dchwebb/DevBoard/Base_Controls.step

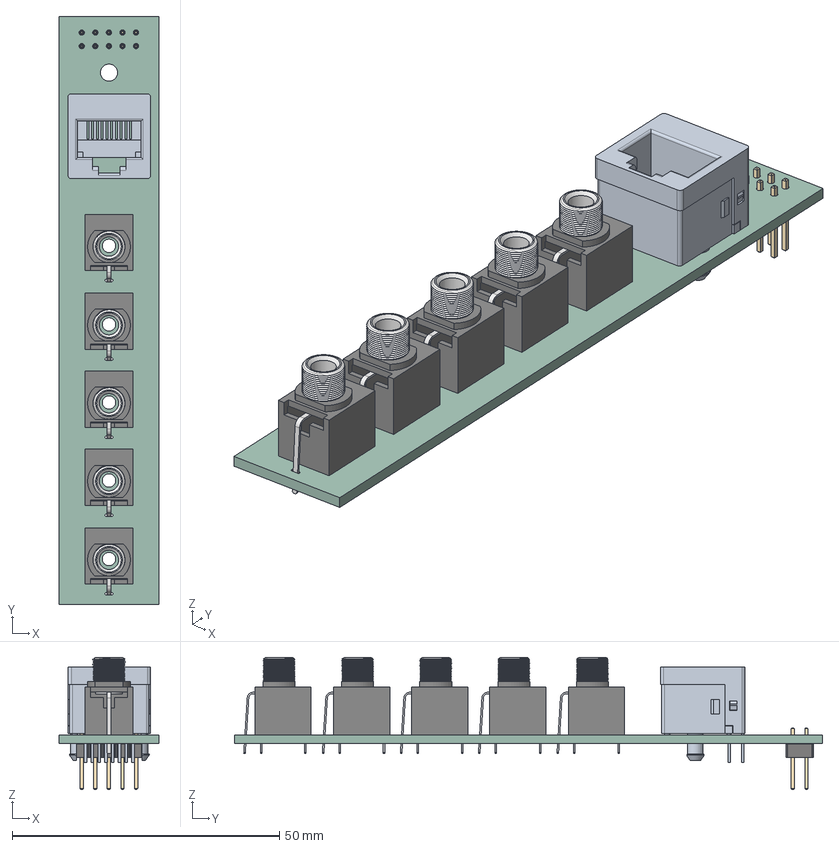
[picture p1: CAD file, 2023-03-30]
Base_Controls.step
18.8 x 110.0 x 24.7 mm
PCB
