dchwebb/DevBoard/Base_Controls.kicad_pcb

## KiCad design Base_Controls.kicad_pcb (2023-08-18)

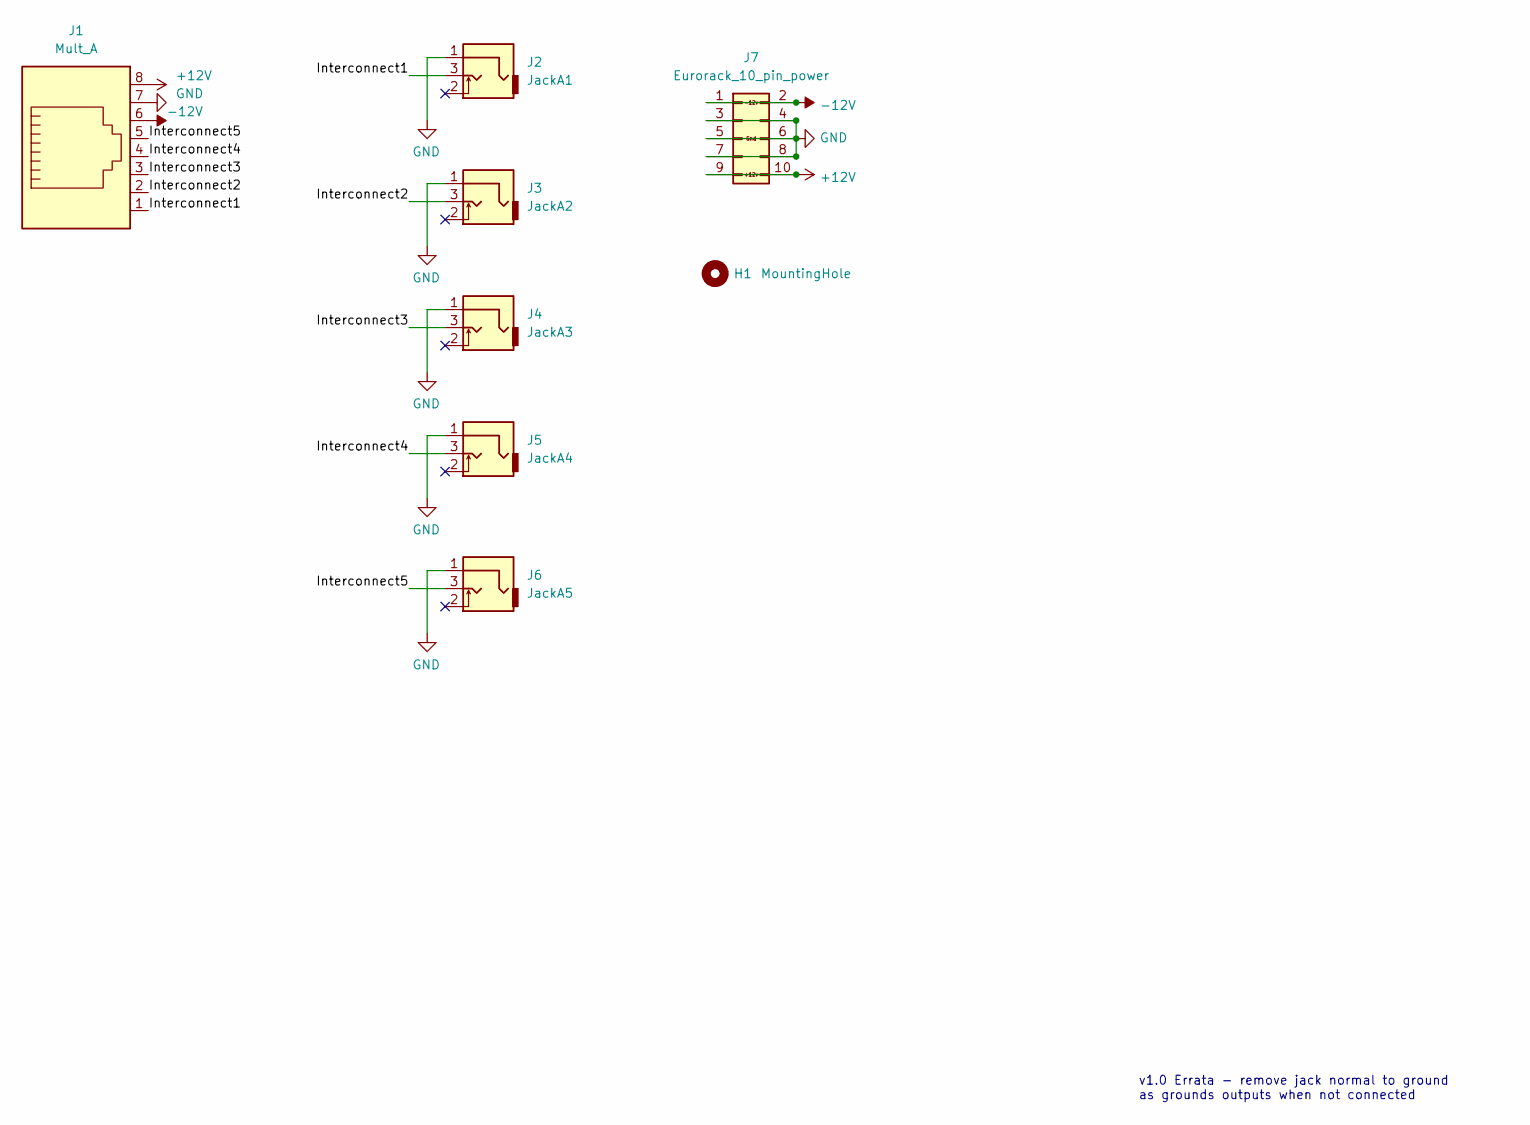
[picture p2: schematic Base_Controls.kicad_sch, Quadraphone Controls]

Parts:
H1: MountingHole; MountingHole_3.2mm_M3_ISO14580
J1: Mult_A; RJ45_Molex_42878-8506
J2: JackA1; THONKICONN_hole
J3: JackA2; THONKICONN_hole
J4: JackA3; THONKICONN_hole
J5: JackA4; THONKICONN_hole
J6: JackA5; THONKICONN_hole
J7: Eurorack_10_pin_power; PinHeader_2x05_P2.54mm_Vertical

Connections:
+12V: J1.8, J7.9, J7.10
-12V: J1.6, J7.1, J7.2
/Interconnect1: J1.1, J2.3
/Interconnect2: J1.2, J3.3
/Interconnect3: J1.3, J4.3
/Interconnect4: J1.4, J5.3
/Interconnect5: J1.5, J6.3
GND: J1.7, J2.1, J3.1, J4.1, J5.1, J6.1, J7.3, J7.4, J7.5, J7.6, J7.7, J7.8

Notes on the sheet:
v1.0 Errata - remove jack normal to ground as grounds outputs when not connected

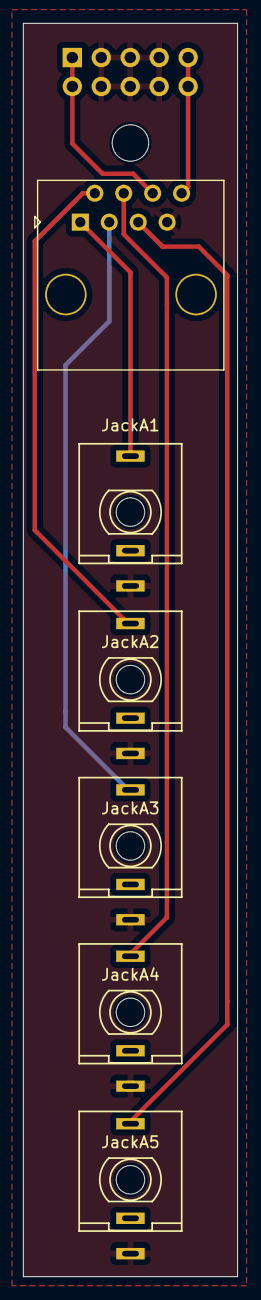
[picture p3: board Base_Controls.kicad_pcb from above]

Board: 2 copper layers, 18.8 x 110.0 mm, 8 parts (1 on the bottom side), 8 nets.
