dchwebb/DevBoard/DevBoard.kicad_pcb

## KiCad design DevBoard.kicad_pcb (2023-03-30)

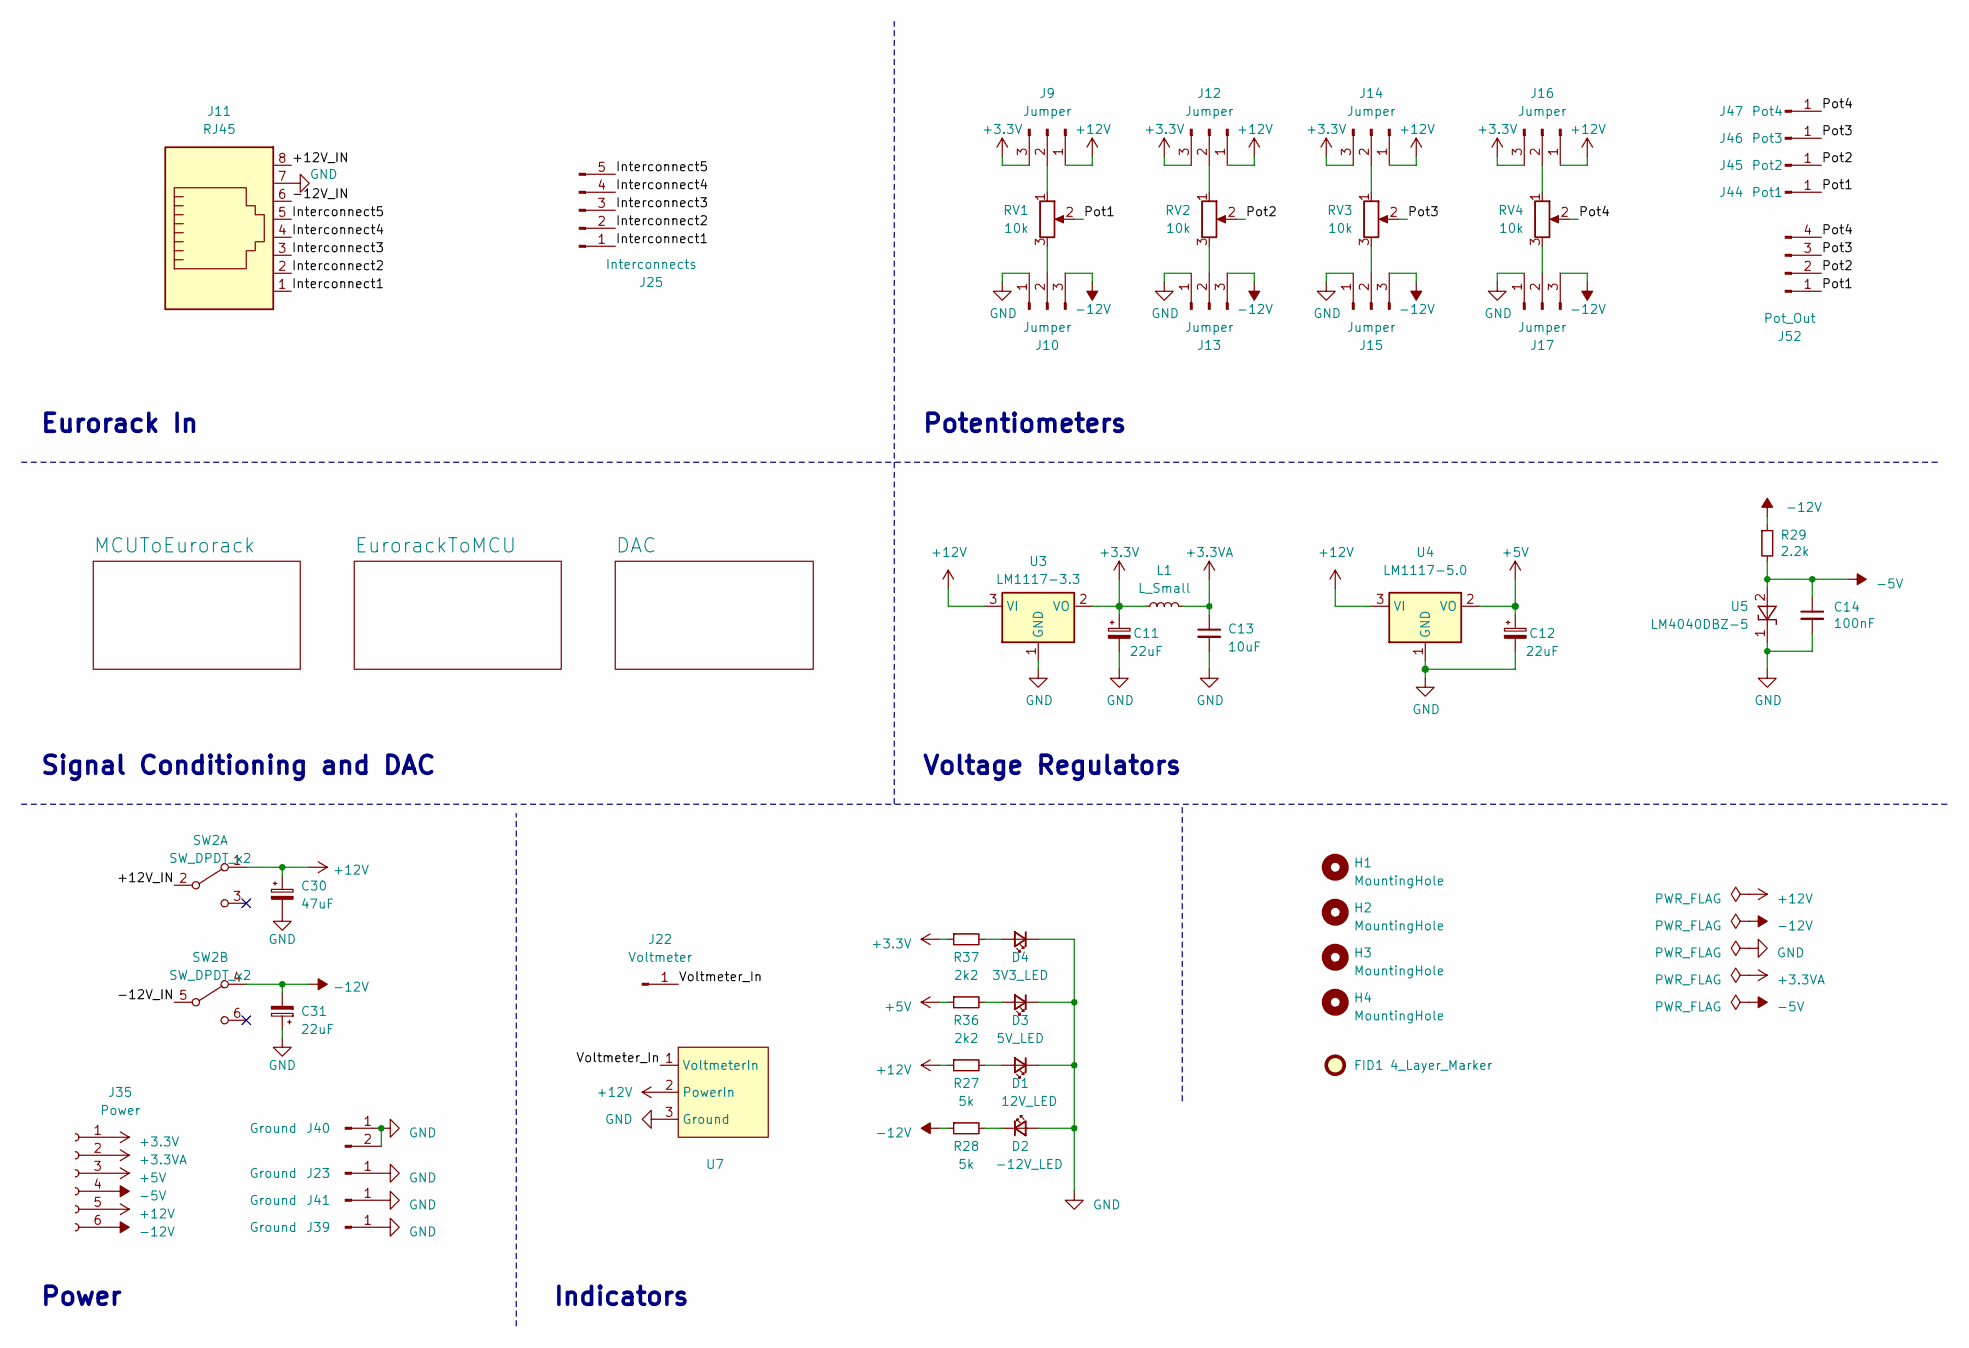
[picture p4: schematic DevBoard.kicad_sch, Eurorack Dev Board]

Parts:
C11, C12, C31: 22uF; CP_Elec_4x5.8
C13: 10uF; C_0805_2012Metric
C14: 100nF; C_0805_2012Metric
C30: 47uF; CP_Elec_5x5.4
D1: 12V_LED; LED_0603_1608Metric
D2: -12V_LED; LED_0603_1608Metric
D3: 5V_LED; LED_0603_1608Metric
D4: 3V3_LED; LED_0603_1608Metric
FID1: 4_Layer_Marker; 4_Layer_Markers
H1, H2, H3, H4: MountingHole; MountingHole_3.2mm_M3
J9, J10, J12, J13, J14, J15, J16, J17: Jumper; PinHeader_1x03_P2.54mm_Vertical
J11: RJ45; RJ45_Amphenol_Style
J22: Voltmeter; PinSocket_1x01_P2.54mm_Vertical
J23, J39, J41: Ground; PinHeader_1x01_P2.54mm_Vertical
J25: Interconnects; PinSocket_1x05_P2.54mm_Vertical
J35: Power; PinSocket_1x06_P2.54mm_Vertical
J40: Ground; PinSocket_1x02_P2.54mm_Vertical
J44: Pot1; PinHeader_1x01_P2.54mm_Vertical
J45: Pot2; PinHeader_1x01_P2.54mm_Vertical
J46: Pot3; PinHeader_1x01_P2.54mm_Vertical
J47: Pot4; PinHeader_1x01_P2.54mm_Vertical
J52: Pot_Out; PinSocket_1x04_P2.54mm_Vertical
L1: L_Small; L_0805_2012Metric_Pad1.05x1.20mm_HandSolder; Part_Number C1046
R27, R28: 5k; R_0805_2012Metric
R29: 2.2k; R_0805_2012Metric
R36, R37: 2k2; R_0805_2012Metric
RV1, RV2, RV3, RV4: 10k; Alpha_9mm_Potentiometer_Aligned
SW2: SW_DPDT_x2; 100DP6T1B1M2QE_ON_ON_ON
U3: LM1117-3.3; SOT-223-3_TabPin2
U4: LM1117-5.0; SOT-223-3_TabPin2
U5: LM4040DBZ-5; SOT-23
U7: MiniVoltmeter

Connections:
+3.3V: C11.1, J9.3, J12.3, J14.3, J16.3, J35.1, L1.1, R37.1, U3.2 (VO); also elsewhere on the board
+3.3VA: C13.1, J35.2, L1.2; also elsewhere on the board
+5V: C12.1, J35.3, R36.1, U4.2 (VO)
+12V: C30.1, J9.1, J12.1, J14.1, J16.1, J35.5, R27.1, SW2.1 (A), U3.3 (VI), U4.3 (VI), U7.2 (PowerIn); also elsewhere on the board
-5V: C14.1, J35.4, R29.2, U5.2 (A); also elsewhere on the board
-12V: C31.2, J10.3, J13.3, J15.3, J17.3, J35.6, R28.1, R29.1, SW2.4 (A); also elsewhere on the board
/+12V_IN: J11.8, SW2.2 (B)
/-12V_IN: J11.6, SW2.5 (B)
/Interconnect1: J11.1, J25.1
/Interconnect2: J11.2, J25.2
/Interconnect3: J11.3, J25.3
/Interconnect4: J11.4, J25.4
/Interconnect5: J11.5, J25.5
/Pot1: J44.1, J52.1, RV1.2
/Pot2: J45.1, J52.2, RV2.2
/Pot3: J46.1, J52.3, RV3.2
/Pot4: J47.1, J52.4, RV4.2
/Voltmeter_In: J22.1, U7.1 (VoltmeterIn)
GND: C11.2, C12.2, C13.2, C14.2, C30.2, C31.1, D1.1 (K), D2.2 (A), D3.1 (K), D4.1 (K), J10.1, J11.7, J13.1, J15.1, J17.1, J23.1, J39.1, J40.1, J40.2, J41.1, U3.1 (GND), U4.1 (GND), U5.1 (K), U7.3 (Ground); also elsewhere on the board
unnamed: D1.2 (A), R27.2
unnamed: D2.1 (K), R28.2
unnamed: D3.2 (A), R36.2
unnamed: D4.2 (A), R37.2
unnamed: J9.2, RV1.1
unnamed: J10.2, RV1.3
unnamed: J12.2, RV2.1
unnamed: J13.2, RV2.3
unnamed: J14.2, RV3.1
unnamed: J15.2, RV3.3
unnamed: J16.2, RV4.1
unnamed: J17.2, RV4.3

Notes on the sheet:
Eurorack In
Potentiometers
Indicators
Power
Voltage Regulators
Signal Conditioning and DAC

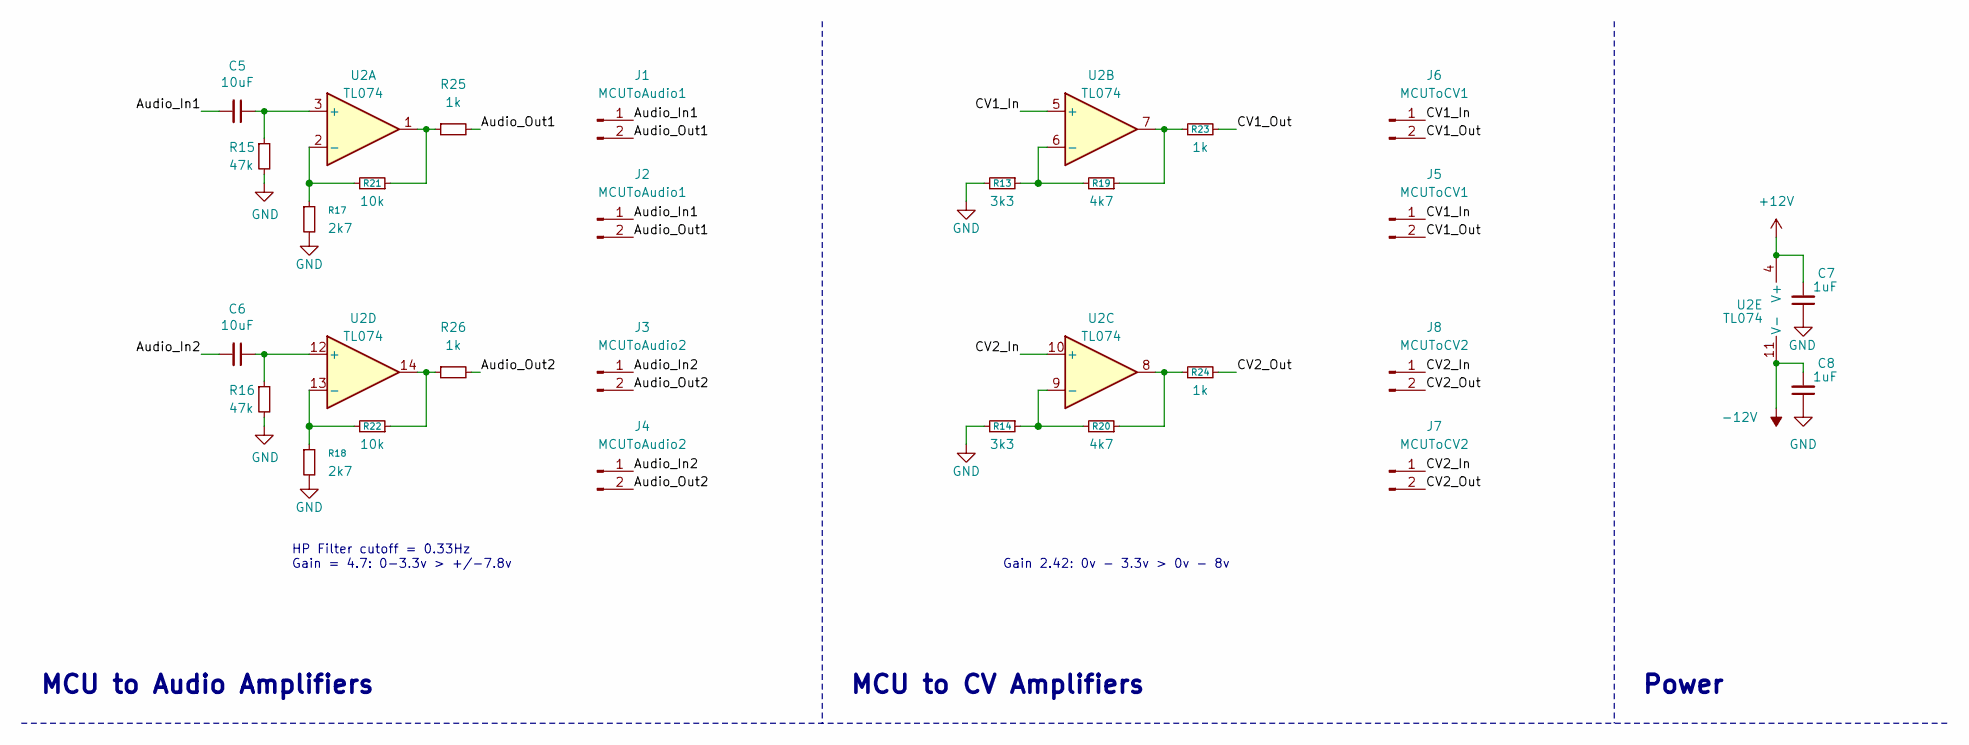
[picture p5: schematic MCUToEurorack.kicad_sch, Eurorack Dev Board]

Parts:
C5, C6: 10uF; C_0805_2012Metric
C7, C8: 1uF; C_0805_2012Metric
J1: MCUToAudio1; PinSocket_1x02_P2.54mm_Vertical
J2: MCUToAudio1; PinHeader_1x02_P2.54mm_Vertical
J3: MCUToAudio2; PinSocket_1x02_P2.54mm_Vertical
J4: MCUToAudio2; PinHeader_1x02_P2.54mm_Vertical
J5: MCUToCV1; PinHeader_1x02_P2.54mm_Vertical
J6: MCUToCV1; PinSocket_1x02_P2.54mm_Vertical
J7: MCUToCV2; PinHeader_1x02_P2.54mm_Vertical
J8: MCUToCV2; PinSocket_1x02_P2.54mm_Vertical
R13, R14: 3k3; R_0805_2012Metric; Part_Number C22978
R15, R16: 47k; R_0805_2012Metric
R17, R18: 2k7; R_0805_2012Metric; Part_Number C22978
R19, R20: 4k7; R_0805_2012Metric; Part_Number C23162
R21, R22: 10k; R_0805_2012Metric; Part_Number C23162
R23, R24: 1k; R_0805_2012Metric; Part_Number C21190
R25, R26: 1k; R_0805_2012Metric
U2: TL074; SOIC-14_3.9x8.7mm_P1.27mm

Connections:
+12V: C7.2, U2.4 (V+); also elsewhere on the board
-12V: C8.2, U2.11 (V-); also elsewhere on the board
/MCUToEurorack/Audio_In1: C5.2, J1.1, J2.1
/MCUToEurorack/Audio_In2: C6.2, J3.1, J4.1
/MCUToEurorack/Audio_Out1: J1.2, J2.2, R25.2
/MCUToEurorack/Audio_Out2: J3.2, J4.2, R26.2
/MCUToEurorack/CV1_In: J5.1, J6.1, U2.5 (+)
/MCUToEurorack/CV1_Out: J5.2, J6.2, R23.2
/MCUToEurorack/CV2_In: J7.1, J8.1, U2.10 (+)
/MCUToEurorack/CV2_Out: J7.2, J8.2, R24.2
GND: C7.1, C8.1, R13.2, R14.2, R15.2, R16.2, R17.2, R18.2; also elsewhere on the board
unnamed: R19.1, R23.1, U2.7
unnamed: R20.1, R24.1, U2.8
unnamed: R21.1, R25.1, U2.1
unnamed: R22.1, R26.1, U2.14
unnamed: C5.1, R15.1, U2.3 (+)
unnamed: R17.1, R21.2, U2.2 (-)
unnamed: R13.1, R19.2, U2.6 (-)
unnamed: R14.1, R20.2, U2.9 (-)
unnamed: C6.1, R16.1, U2.12 (+)
unnamed: R18.1, R22.2, U2.13 (-)

Notes on the sheet:
HP Filter cutoff = 0.33Hz Gain = 4.7: 0-3.3v > +/-7.8v
MCU to Audio Amplifiers
MCU to CV Amplifiers
Gain 2.42: 0v - 3.3v > 0v - 8v
Power

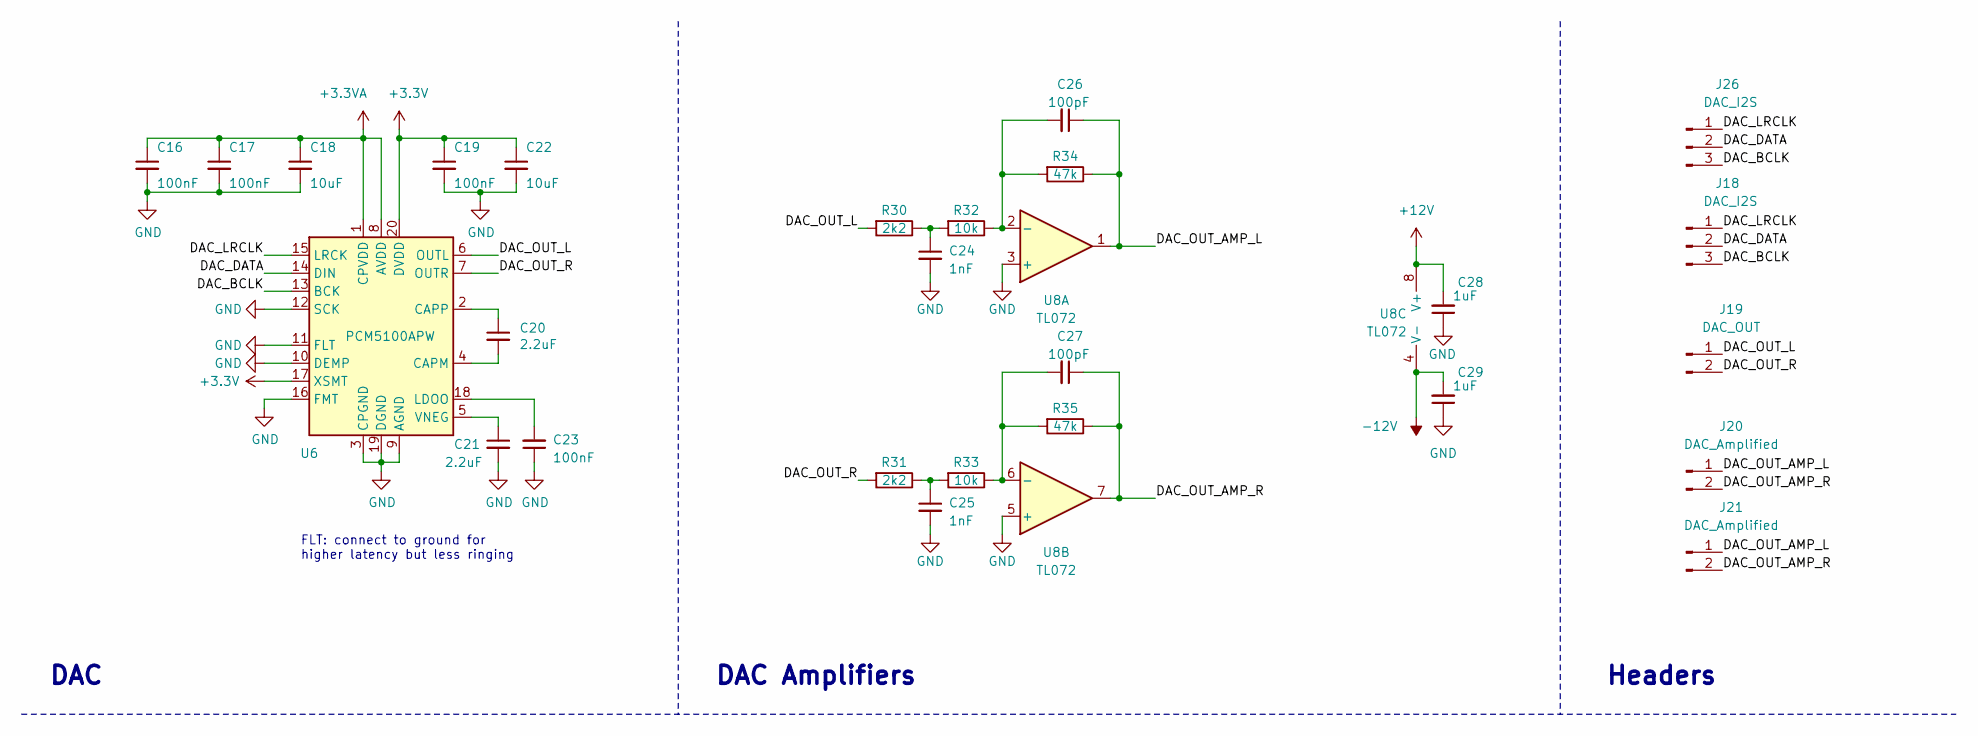
[picture p6: schematic DAC.kicad_sch, Eurorack Dev Board]

Parts:
C16, C17, C19, C23: 100nF; C_0805_2012Metric; Part_Number C14663
C18, C22: 10uF; C_0805_2012Metric; Part_Number C15850
C20, C21: 2.2uF; C_0805_2012Metric; Part_Number C23630
C24, C25: 1nF; C_0805_2012Metric; Part_Number C1588
C26, C27: 100pF; C_0805_2012Metric; Part_Number C14858
C28, C29: 1uF; C_0805_2012Metric
J18: DAC_I2S; PinHeader_1x03_P2.54mm_Vertical
J19: DAC_OUT; PinHeader_1x02_P2.54mm_Vertical
J20: DAC_Amplified; PinSocket_1x02_P2.54mm_Vertical
J21: DAC_Amplified; PinHeader_1x02_P2.54mm_Vertical
J26: DAC_I2S; PinSocket_1x03_P2.54mm_Vertical
R30, R31: 2k2; R_0805_2012Metric; Part_Number C4190
R32, R33: 10k; R_0805_2012Metric; Part_Number C25804
R34, R35: 47k; R_0805_2012Metric; Part_Number C25819
U6: PCM5100APW; TSSOP-20_4.4x6.5mm_P0.65mm; Part_Number C131154
U8: TL072; SOIC-8_3.9x4.9mm_P1.27mm; Part_Number C6961

Connections:
+3.3V: C19.1, C22.1, U6.17 (XSMT), U6.20 (DVDD); also elsewhere on the board
+3.3VA: C16.1, C17.1, C18.1, U6.1 (CPVDD), U6.8 (AVDD); also elsewhere on the board
+12V: C28.2, U8.8 (V+); also elsewhere on the board
-12V: C29.2, U8.4 (V-); also elsewhere on the board
/DAC/DAC_BCLK: J18.3, J26.3, U6.13 (BCK)
/DAC/DAC_DATA: J18.2, J26.2, U6.14 (DIN)
/DAC/DAC_LRCLK: J18.1, J26.1, U6.15 (LRCK)
/DAC/DAC_OUT_AMP_L: C26.1, J20.1, J21.1, R34.1, U8.1
/DAC/DAC_OUT_AMP_R: C27.1, J20.2, J21.2, R35.1, U8.7
/DAC/DAC_OUT_L: J19.1, R30.2, U6.6 (OUTL)
/DAC/DAC_OUT_R: J19.2, R31.2, U6.7 (OUTR)
GND: C16.2, C17.2, C18.2, C19.2, C21.2, C22.2, C23.1, C24.2, C25.2, C28.1, C29.1, U6.3 (CPGND), U6.9 (AGND), U6.10 (DEMP), U6.11 (FLT), U6.12 (SCK), U6.16 (FMT), U6.19 (DGND), U8.3 (+), U8.5 (+); also elsewhere on the board
unnamed: C24.1, R30.1, R32.2
unnamed: C25.1, R31.1, R33.2
unnamed: C20.2, U6.4 (CAPM)
unnamed: C20.1, U6.2 (CAPP)
unnamed: C23.2, U6.18 (LDOO)
unnamed: C21.1, U6.5 (VNEG)
unnamed: C26.2, R32.1, R34.2, U8.2 (-)
unnamed: C27.2, R33.1, R35.2, U8.6 (-)

Notes on the sheet:
Headers
DAC Amplifiers
DAC
FLT: connect to ground for higher latency but less ringing

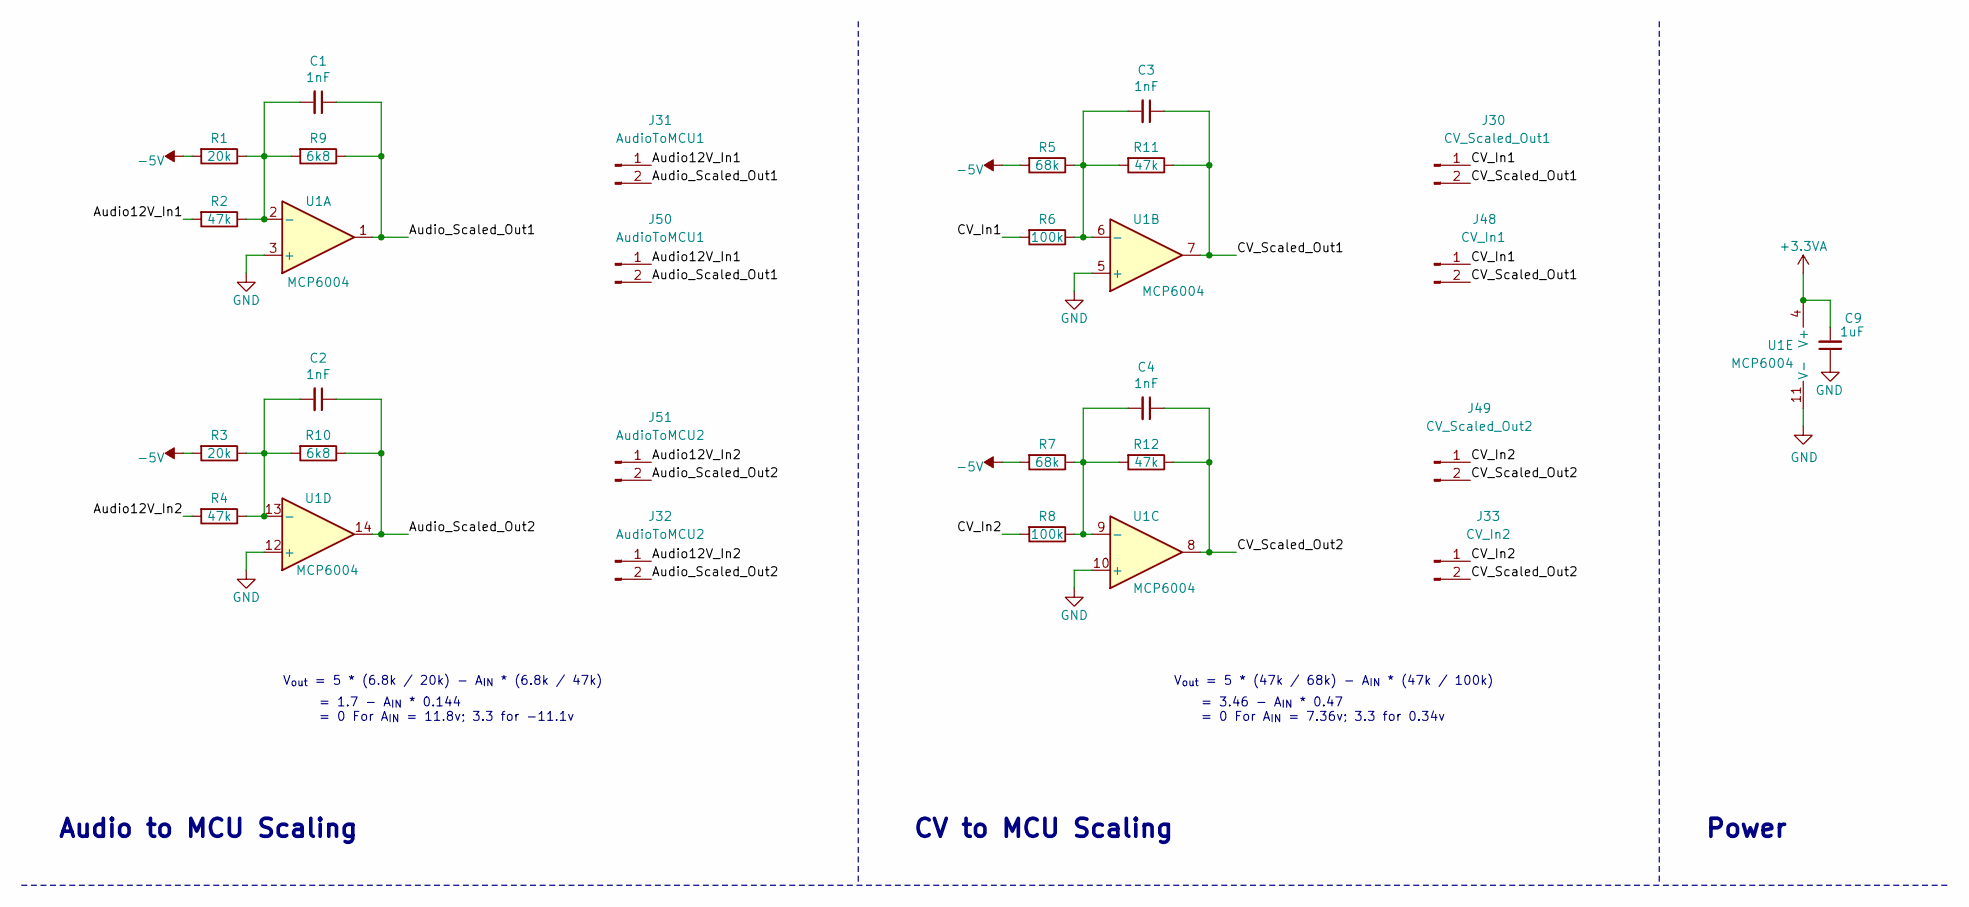
[picture p7: schematic EurorackToMCU.kicad_sch, Eurorack Dev Board]

Parts:
C1, C2, C3, C4: 1nF; C_0805_2012Metric; Part_Number C1595
C9: 1uF; C_0805_2012Metric
J30: CV_Scaled_Out1; PinSocket_1x02_P2.54mm_Vertical
J31: AudioToMCU1; PinSocket_1x02_P2.54mm_Vertical
J32: AudioToMCU2; PinHeader_1x02_P2.54mm_Vertical
J33: CV_In2; PinHeader_1x02_P2.54mm_Vertical
J48: CV_In1; PinHeader_1x02_P2.54mm_Vertical
J49: CV_Scaled_Out2; PinSocket_1x02_P2.54mm_Vertical
J50: AudioToMCU1; PinHeader_1x02_P2.54mm_Vertical
J51: AudioToMCU2; PinSocket_1x02_P2.54mm_Vertical
R1, R3: 20k; R_0805_2012Metric; Part_Number C4184
R2, R4, R11, R12: 47k; R_0805_2012Metric; Part_Number C25819
R5, R7: 68k; R_0805_2012Metric; Part_Number C23231
R6, R8: 100k; R_0805_2012Metric; Part_Number C25803
R9, R10: 6k8; R_0805_2012Metric; Part_Number C23212
U1: MCP6004; SOIC-14_3.9x8.7mm_P1.27mm; Part_Number C116668

Connections:
+3.3VA: C9.2, U1.4 (V+); also elsewhere on the board
-5V: R1.2, R3.2, R5.2, R7.2; also elsewhere on the board
/EurorackToMCU/Audio12V_In1: J31.1, J50.1, R2.2
/EurorackToMCU/Audio12V_In2: J32.1, J51.1, R4.2
/EurorackToMCU/Audio_Scaled_Out1: C1.1, J31.2, J50.2, R9.1, U1.1
/EurorackToMCU/Audio_Scaled_Out2: C2.1, J32.2, J51.2, R10.1, U1.14
/EurorackToMCU/CV_In1: J30.1, J48.1, R6.2
/EurorackToMCU/CV_In2: J33.1, J49.1, R8.2
/EurorackToMCU/CV_Scaled_Out1: C3.1, J30.2, J48.2, R11.1, U1.7
/EurorackToMCU/CV_Scaled_Out2: C4.1, J33.2, J49.2, R12.1, U1.8
GND: C9.1, U1.3 (+), U1.5 (+), U1.10 (+), U1.11 (V-), U1.12 (+); also elsewhere on the board
unnamed: C1.2, R1.1, R2.1, R9.2, U1.2 (-)
unnamed: C3.2, R5.1, R6.1, R11.2, U1.6 (-)
unnamed: C4.2, R7.1, R8.1, R12.2, U1.9 (-)
unnamed: C2.2, R3.1, R4.1, R10.2, U1.13 (-)

Notes on the sheet:
Power
Audio to MCU Scaling
CV to MCU Scaling
V_{out} = 5 * (6.8k / 20k) - A_{IN} * (6.8k / 47k)
V_{out} = 5 * (47k / 68k) - A_{IN} * (47k / 100k)
= 3.46 - A_{IN} * 0.47 = 0 For A_{IN} = 7.36v; 3.3 for 0.34v
= 1.7 - A_{IN} * 0.144 = 0 For A_{IN} = 11.8v; 3.3 for -11.1v

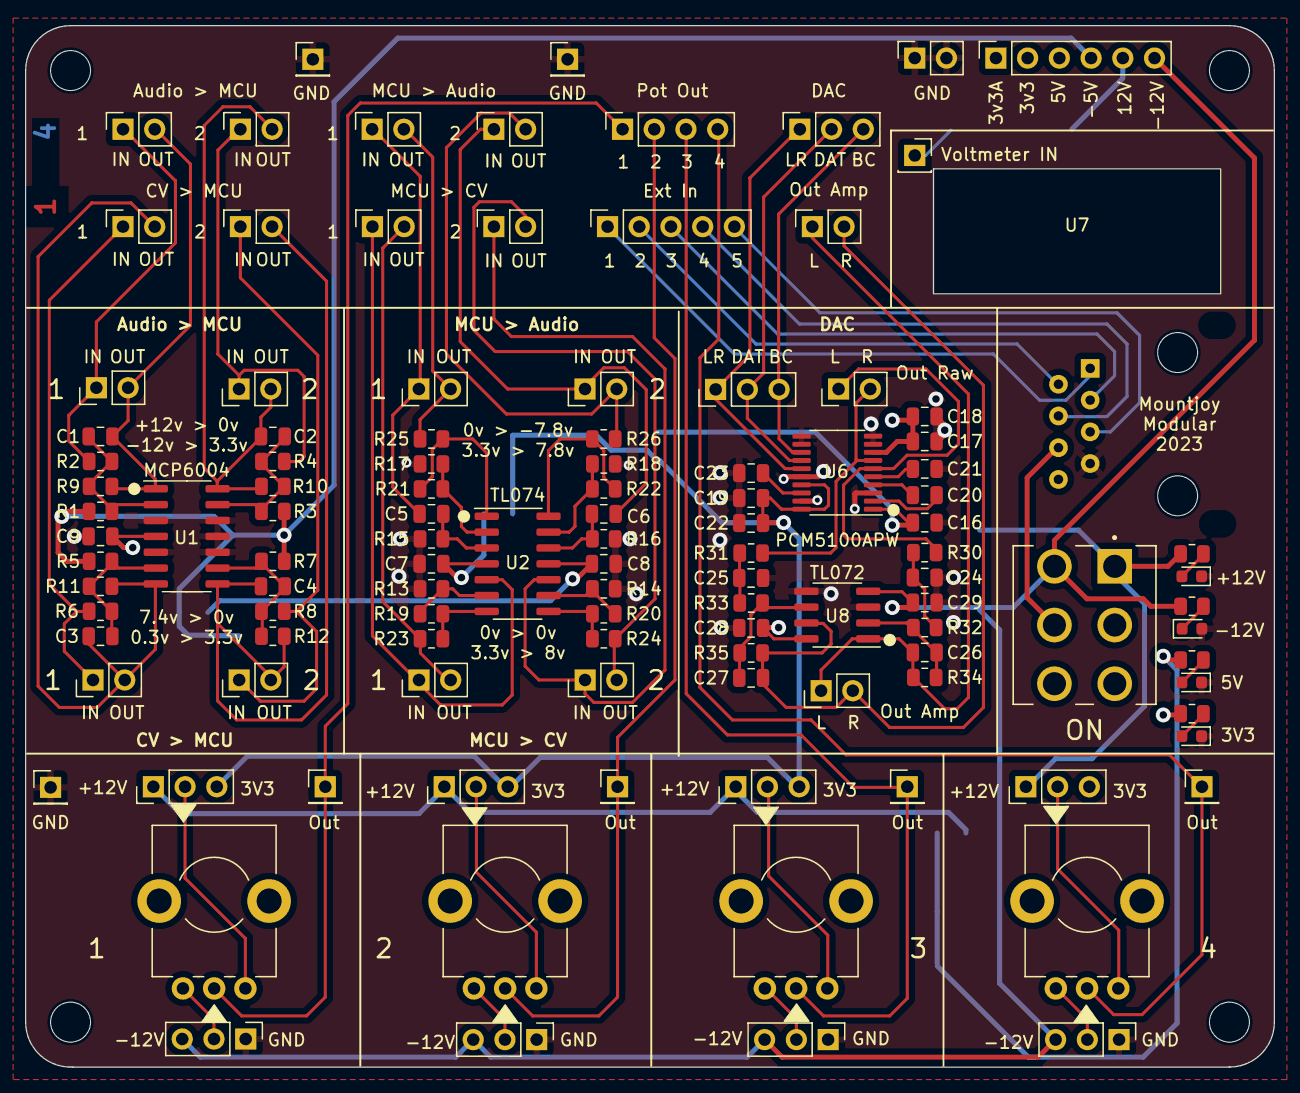
[picture p8: board DevBoard.kicad_pcb from above]

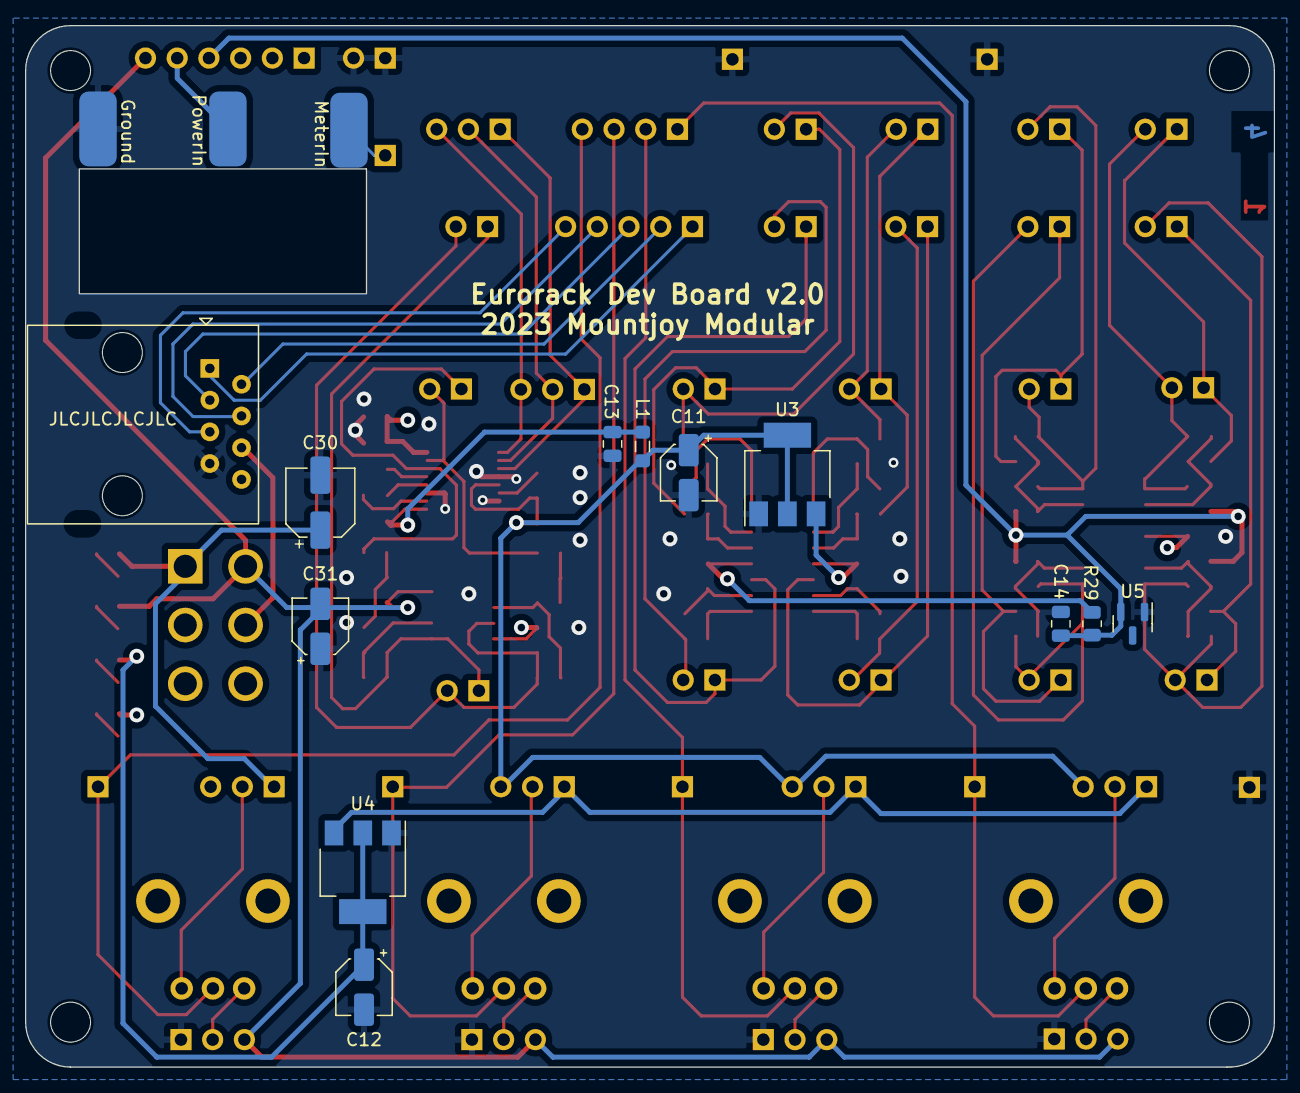
[picture p9: board DevBoard.kicad_pcb from below]

Board: 4 copper layers, 100.0 x 83.4 mm, 131 parts (12 on the bottom side), 76 nets.
