dchwebb/DevBoard/bu/DevBoard.kicad_pcb

## KiCad design bu/DevBoard.kicad_pcb (2018-12-04)

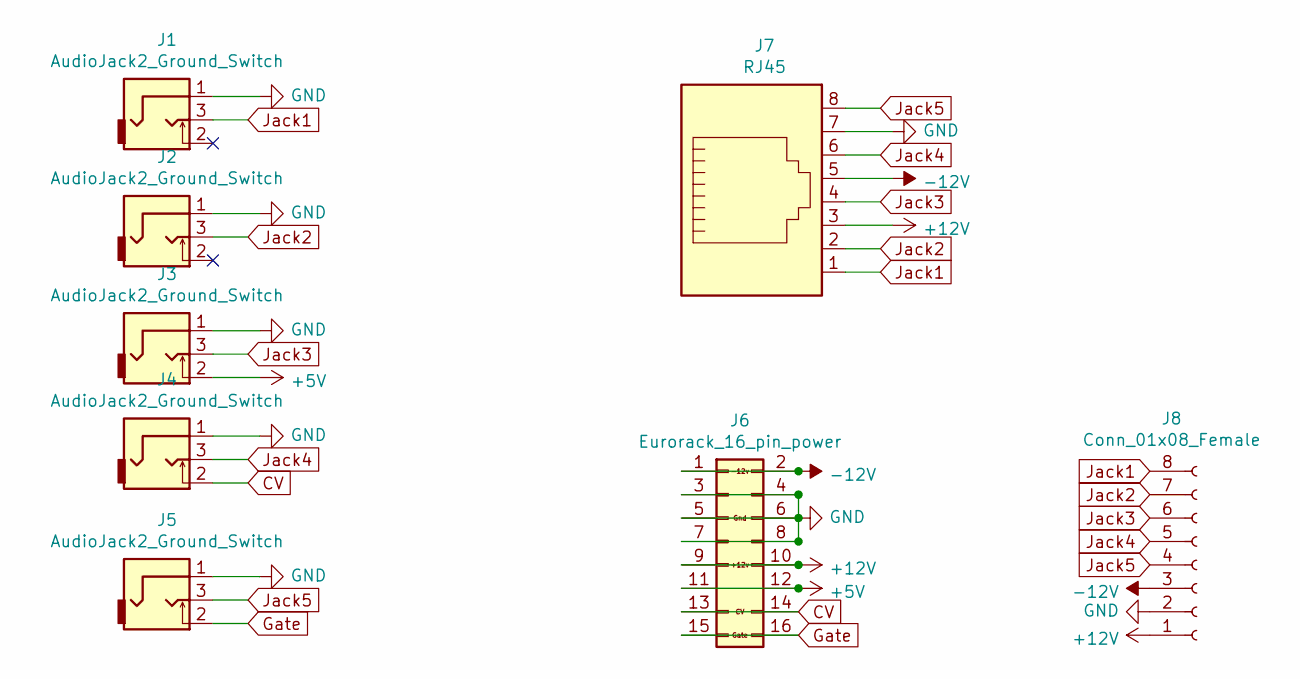
[picture p10: schematic DevBoard.sch]

Parts:
J1, J2, J3, J4, J5: AudioJack2_Ground_Switch; THONKICONN_hole
J6: Eurorack_16_pin_power; Eurorack_16_pin_header
J7: RJ45; RJ45_8
J8: Conn_01x08_Female; Pin_Header_Straight_1x08_Pitch2.54mm

Connections:
+5V: J3.2, J6.11, J6.12
+12V: J6.9, J6.10, J7.3, J8.1
-12V: J6.1, J6.2, J7.5, J8.3
CV: J4.2, J6.13, J6.14
GND: J1.1, J2.1, J3.1, J4.1, J5.1, J6.3, J6.4, J6.5, J6.6, J6.7, J6.8, J7.7, J8.2
Gate: J5.2, J6.15, J6.16
Jack1: J1.3, J7.1, J8.8
Jack2: J2.3, J7.2, J8.7
Jack3: J3.3, J7.4, J8.6
Jack4: J4.3, J7.6, J8.5
Jack5: J5.3, J7.8, J8.4

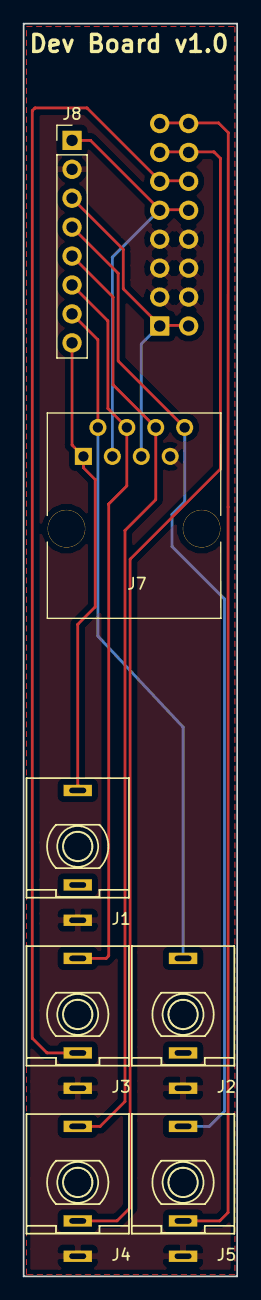
[picture p11: board bu/DevBoard.kicad_pcb from above]

Board: 2 copper layers, 18.8 x 110.0 mm, 8 parts (1 on the bottom side), 11 nets.
