dchwebb/DevBoard/(commit log)

2023-03-12 Started mark 2 Dev Board
    [DevBoard-B.Cu.gbr, DevBoard-B.Mask.gbr, DevBoard-B.SilkS.gbr, DevBoard-Edge.Cuts.gbr, DevBoard-F.Cu.gbr, DevBoard-F.Mask.gbr, DevBoard-F.SilkS.gbr, DevBoard-NPTH.drl]
2023-03-25 First draft of schematic done; started laying out PCB
    [DevBoard.kicad_pcb, DevBoard.kicad_sch]
2023-03-25 Started PCB layout
    [DevBoard.kicad_pcb, DevBoard.kicad_sch]
2023-03-27 Routing scaling circuits
    [DevBoard.kicad_pcb]
2023-03-27 Further layout
    [DevBoard.kicad_pcb, DevBoard.kicad_sch]
2023-03-28 PCB Updates
    [DevBoard.kicad_pcb, DevBoard.kicad_sch]
2023-03-28 First draft routing completed
    [DevBoard.kicad_pcb, DevBoard.kicad_sch]
2023-03-28 Cleaned up schematic
    [DAC.kicad_sch, DevBoard.kicad_pcb, DevBoard.kicad_sch, EurorackToMCU.kicad_sch, MCUToEurorack.kicad_sch, untitled.kicad_sch]
2023-03-29 Layout tweaks
    [DAC.kicad_sch, DevBoard.kicad_pcb, DevBoard.kicad_sch, EurorackToMCU.kicad_sch, MCUToEurorack.kicad_sch]
2023-03-30 Preparing for production
    [Base_Controls-B_Cu.gbr, Base_Controls-B_Mask.gbr, Base_Controls-B_Paste.gbr, Base_Controls-B_Silkscreen.gbr, Base_Controls-Edge_Cuts.gbr, Base_Controls-F_Cu.gbr, Base_Controls-F_Mask.gbr, Base_Controls-F_Paste.gbr]
2023-08-18 Fixed normal to ground of base unit jacks
    [Base_Controls-B_Cu.gbr, Base_Controls-B_Mask.gbr, Base_Controls-B_Paste.gbr, Base_Controls-B_Silkscreen.gbr, Base_Controls-Edge_Cuts.gbr, Base_Controls-F_Cu.gbr, Base_Controls-F_Mask.gbr, Base_Controls-F_Paste.gbr]
